domichel/black_star_theremin/Pictures/Complete Black Star Theremin.jpg

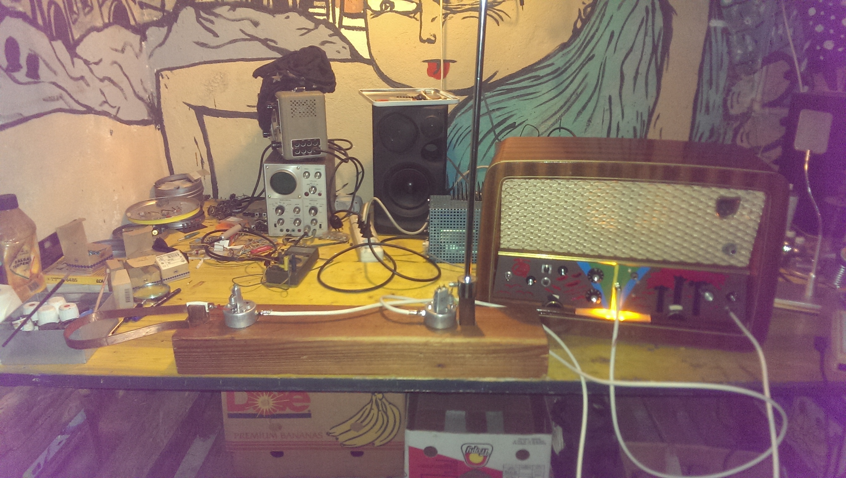
Pictures/Complete Black Star Theremin.jpg
