domichel/black_star_theremin/Pictures/From the front.jpg

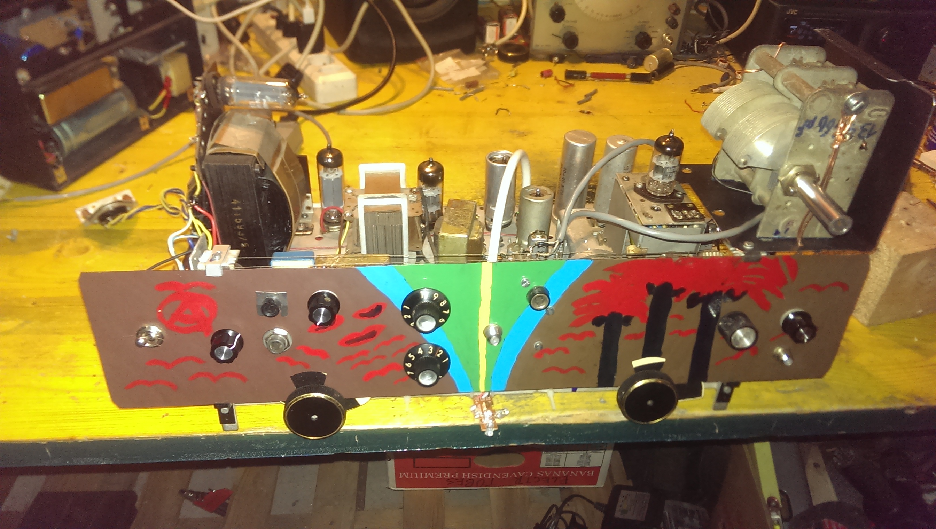
Pictures/From the front.jpg
