domichel/black_star_theremin/Amplifier.jpeg

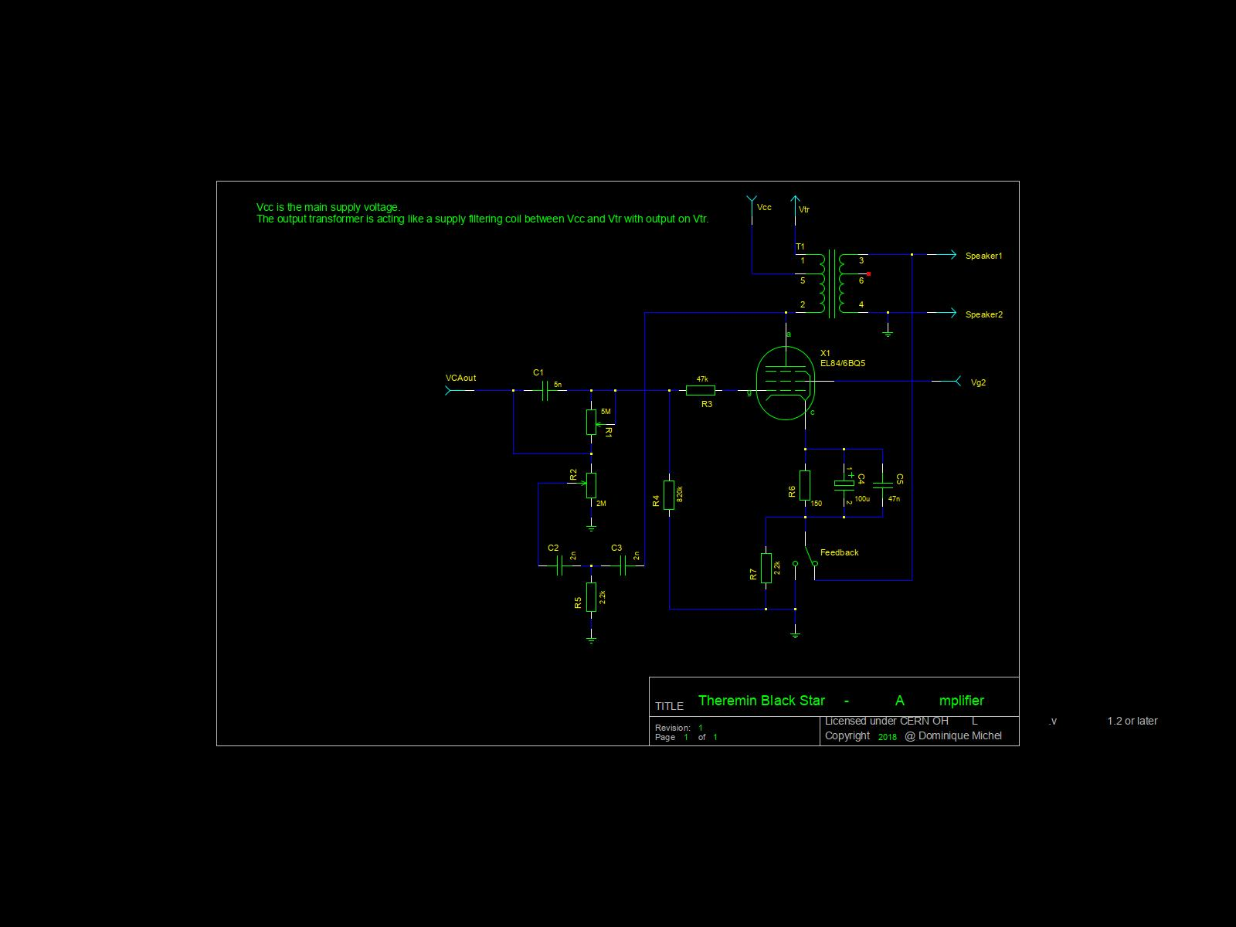
Amplifier.jpeg
