domichel/black_star_theremin/bs451.jpg

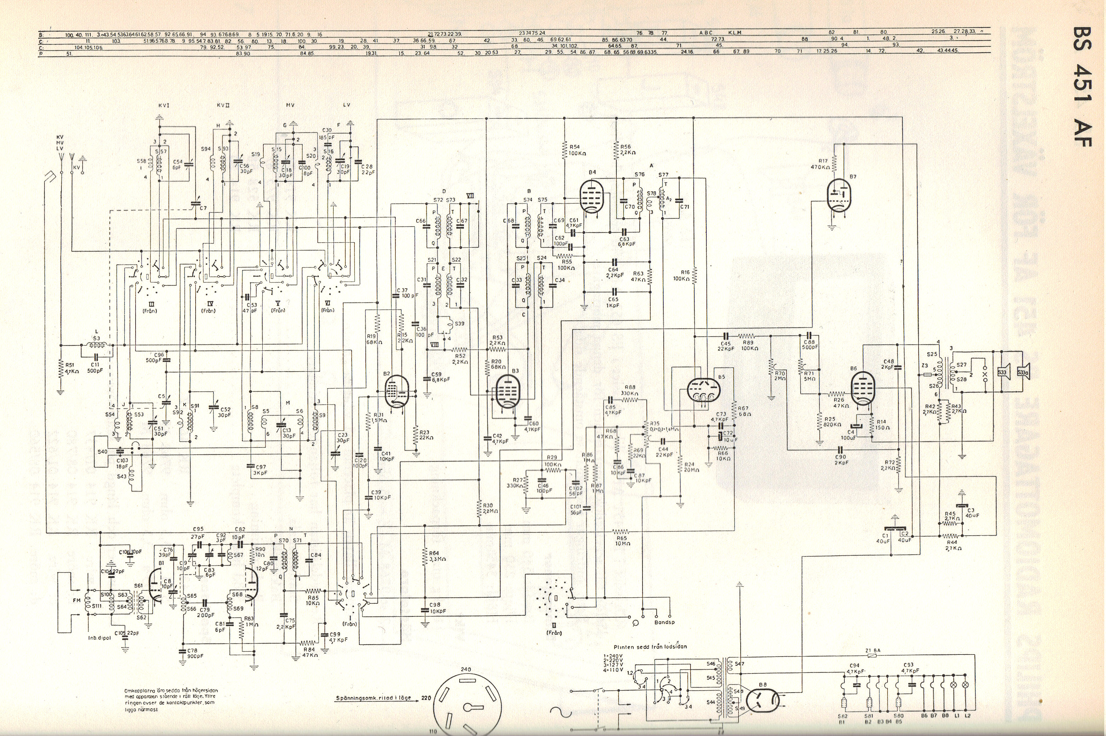
bs451.jpg
