domichel/black_star_theremin/DC_Heater_Supply.jpeg

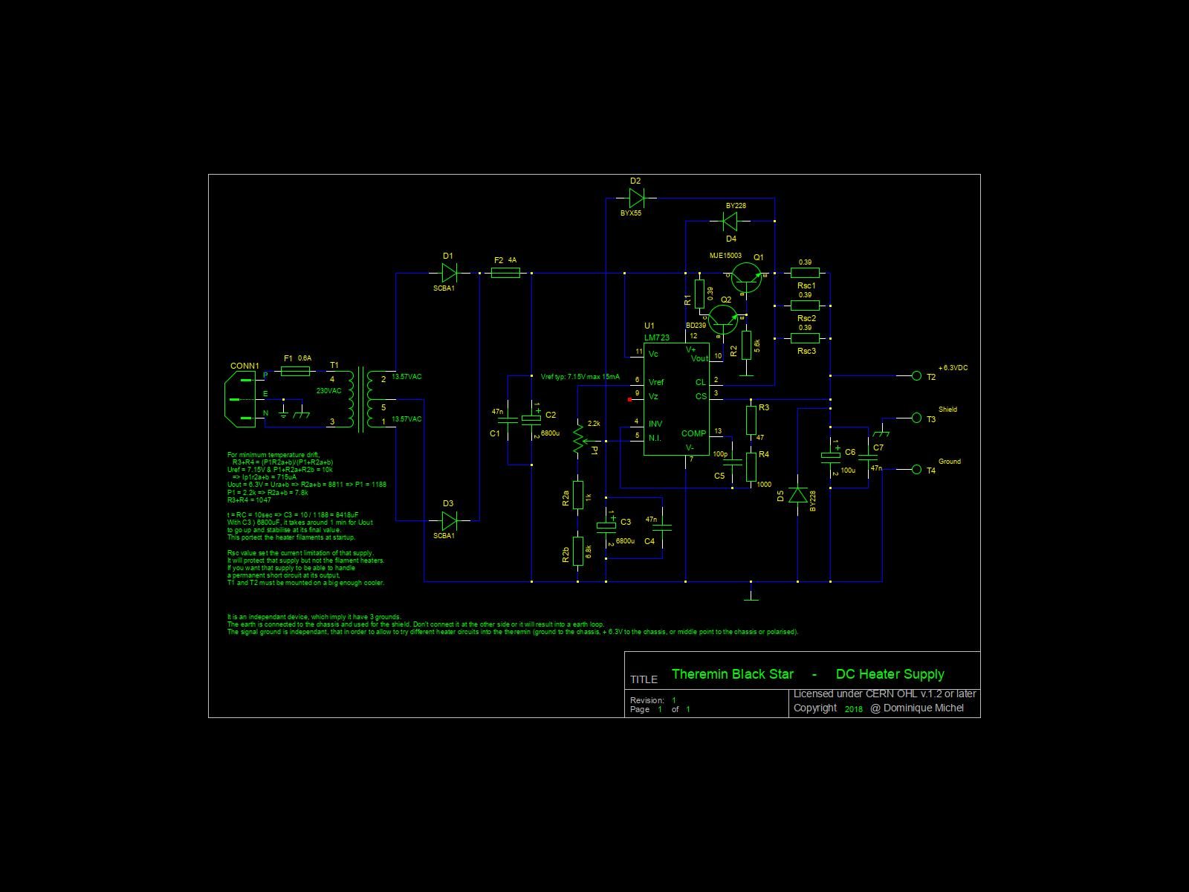
DC_Heater_Supply.jpeg
