domichel/black_star_theremin/Mixer.jpeg

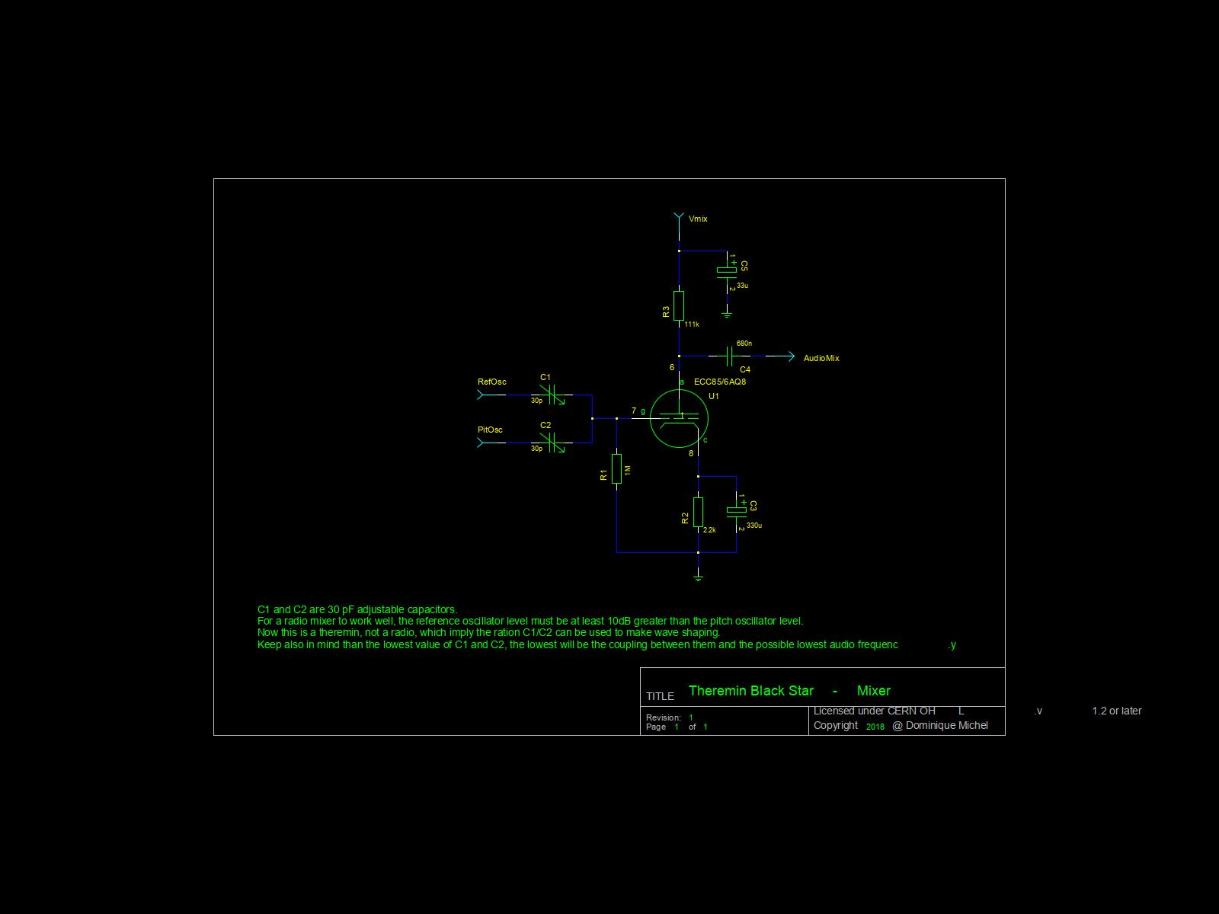
Mixer.jpeg
