domichel/black_star_theremin/Pictures/Black Star Theremin.jpg

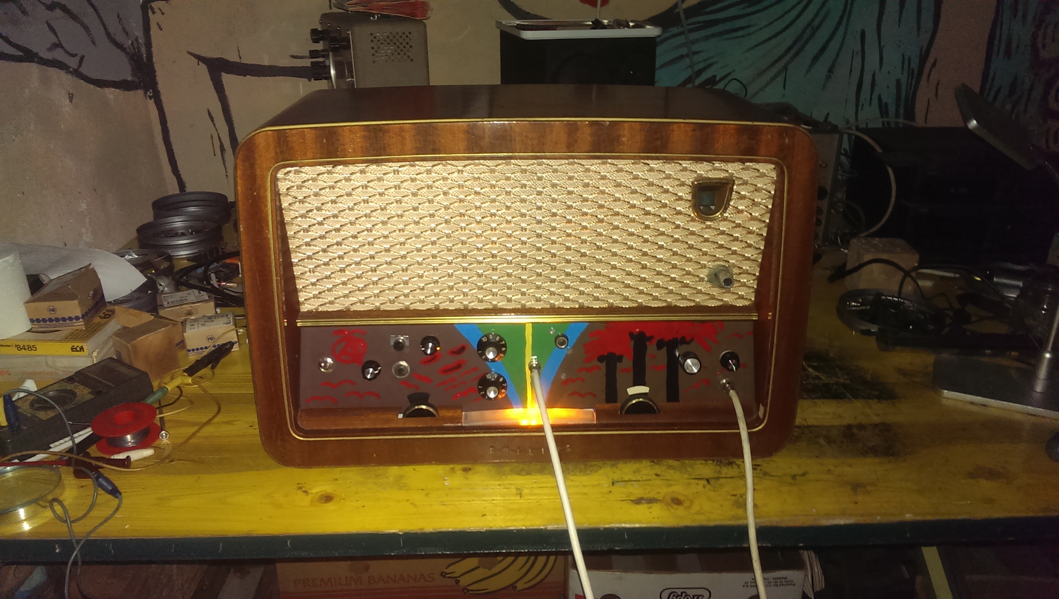
Pictures/Black Star Theremin.jpg
