domichel/black_star_theremin/Pictures/Commands.jpg

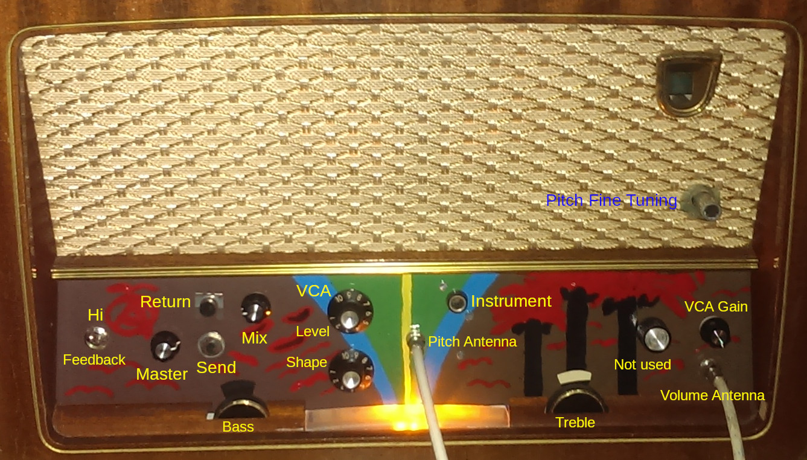
Pictures/Commands.jpg
