domichel/black_star_theremin/Pictures/External DC Heater Supply.jpg

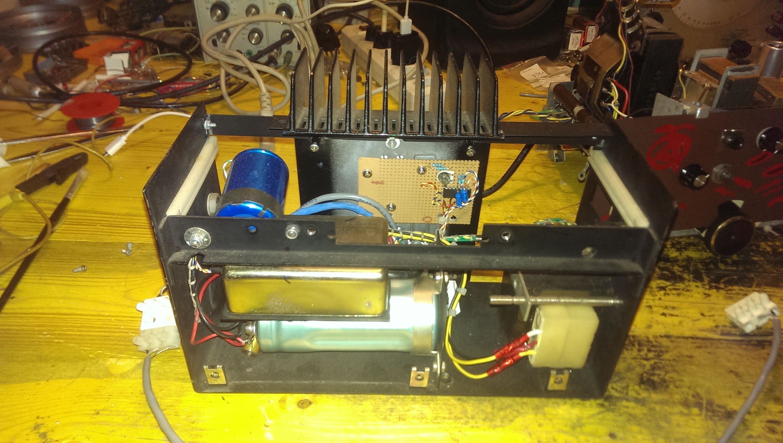
Pictures/External DC Heater Supply.jpg
