domichel/black_star_theremin/Pictures/It begin to work as a theremin.jpg

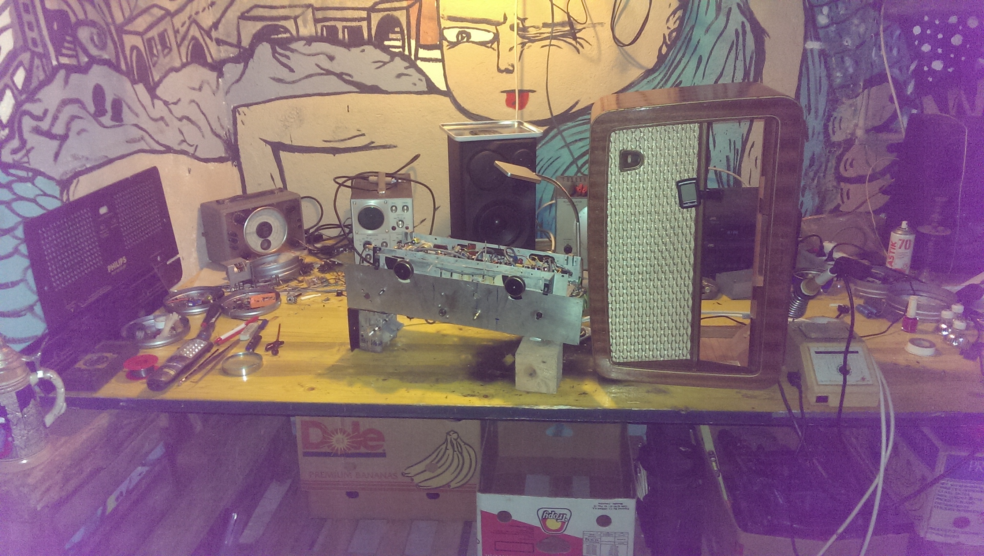
Pictures/It begin to work as a theremin.jpg
