domichel/black_star_theremin/Pictures/It fit inside.jpg

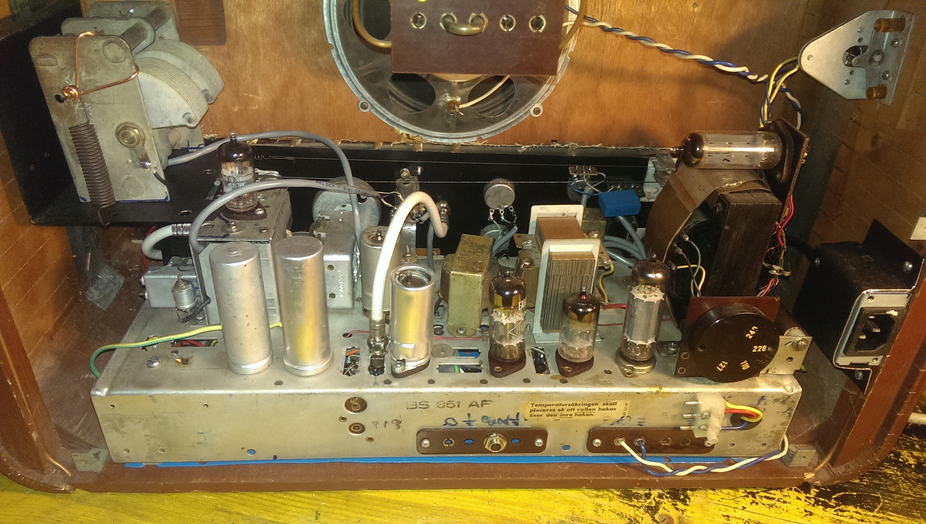
Pictures/It fit inside.jpg
