domichel/black_star_theremin/Pictures/Original radio from the back.jpg

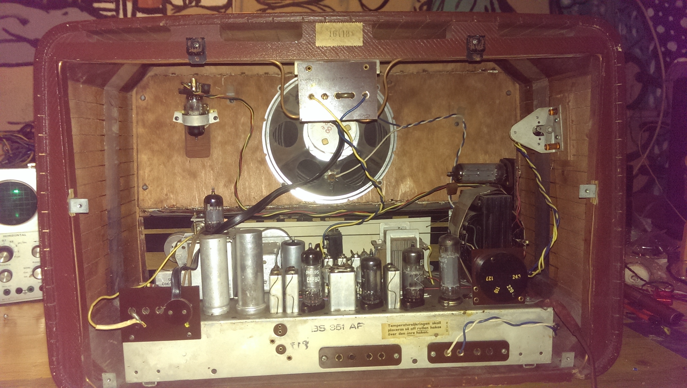
Pictures/Original radio from the back.jpg
