domichel/black_star_theremin/Pictures/Original radio.jpg

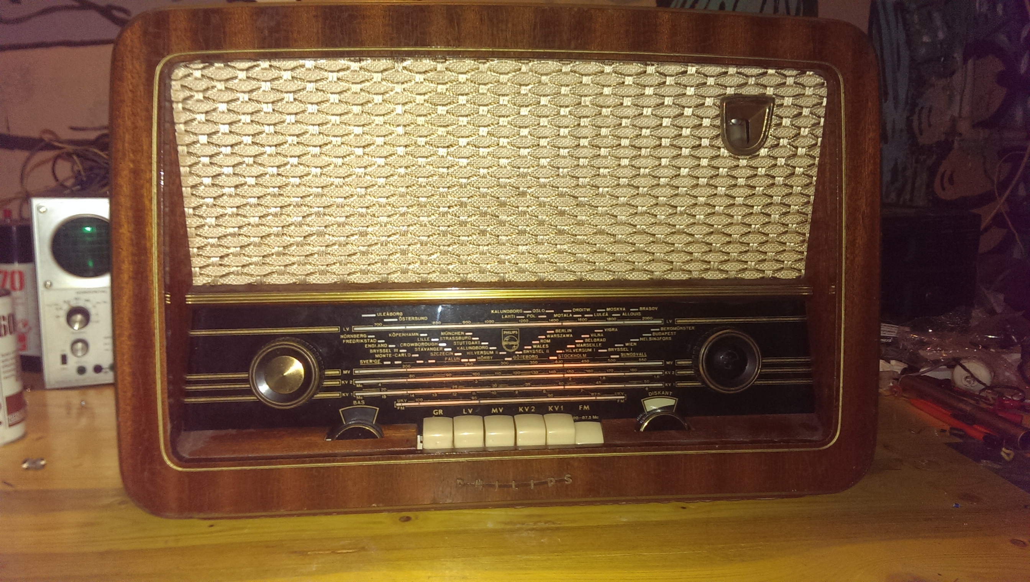
Pictures/Original radio.jpg
