domichel/black_star_theremin/Pictures/The antennas v1.jpg

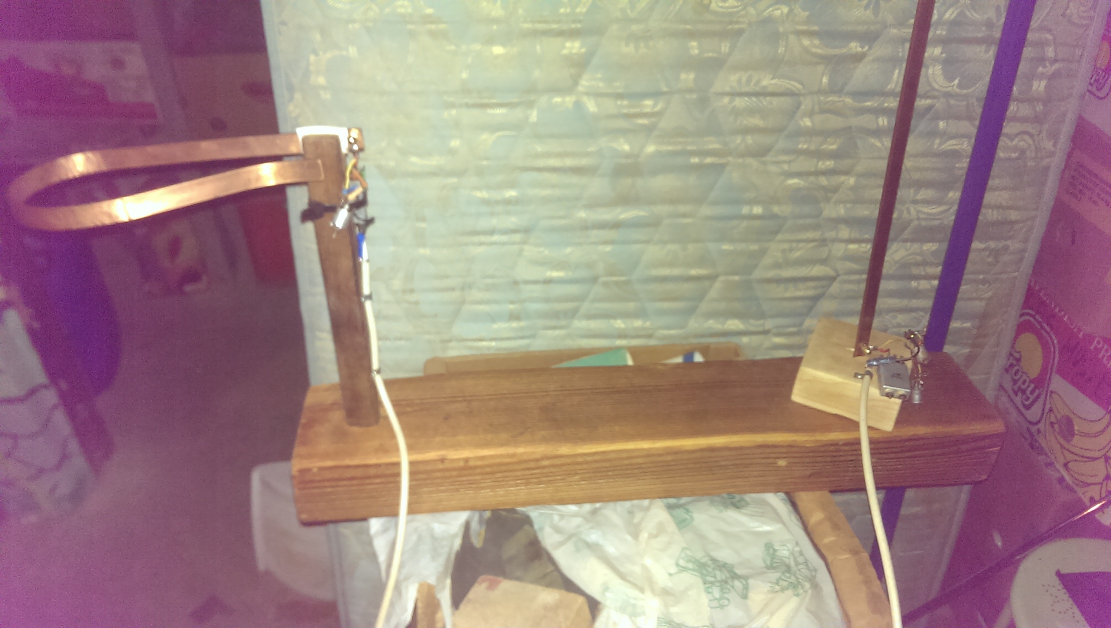
Pictures/The antennas v1.jpg
