domichel/black_star_theremin/Pictures/The antennas v2.jpg

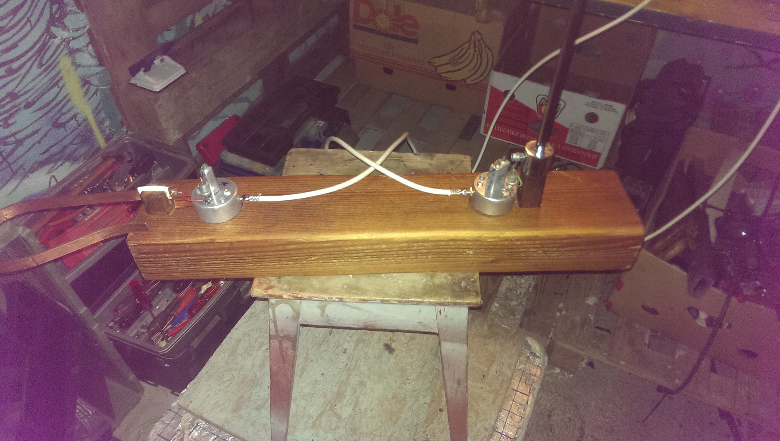
Pictures/The antennas v2.jpg
