domichel/black_star_theremin/Pictures/The inside.jpg

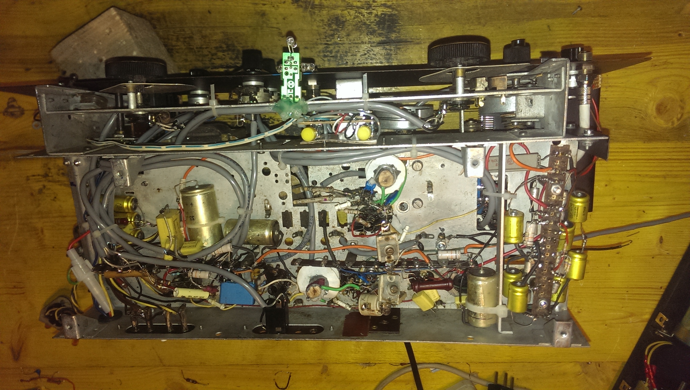
Pictures/The inside.jpg
