domichel/black_star_theremin/PitchOscillator.jpeg

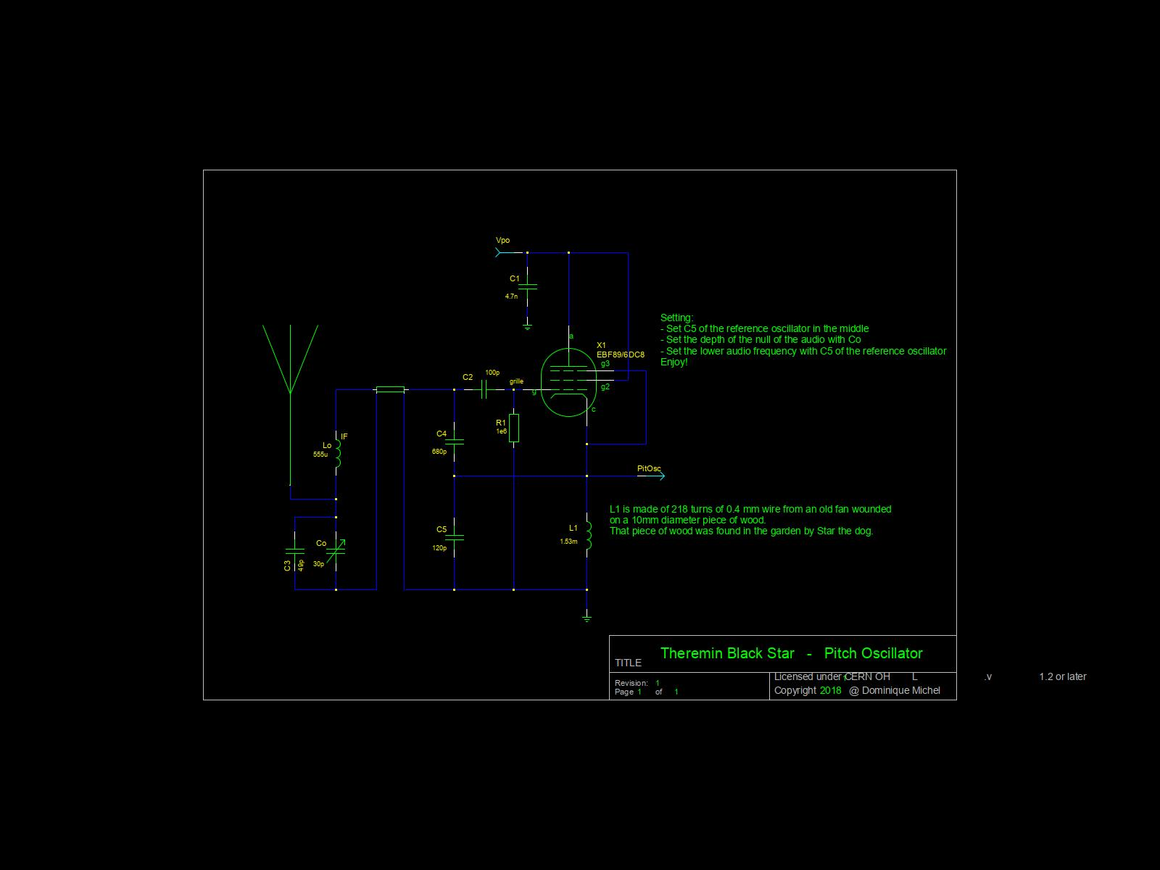
PitchOscillator.jpeg
