domichel/black_star_theremin/Powersupply.jpeg

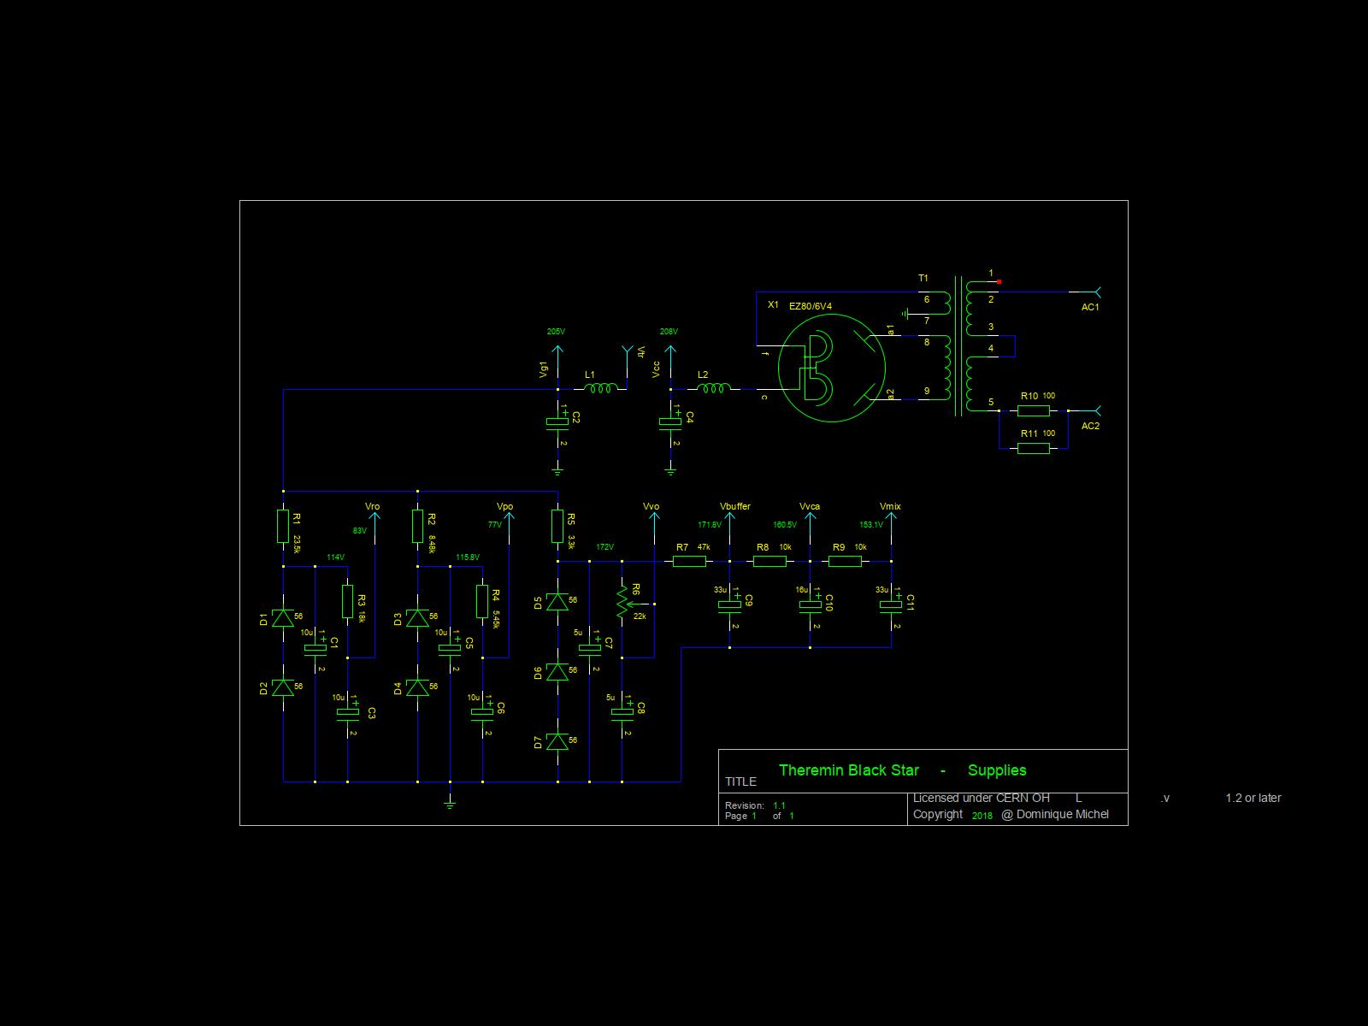
Powersupply.jpeg
