domichel/black_star_theremin/ReferenceOscillator.jpeg

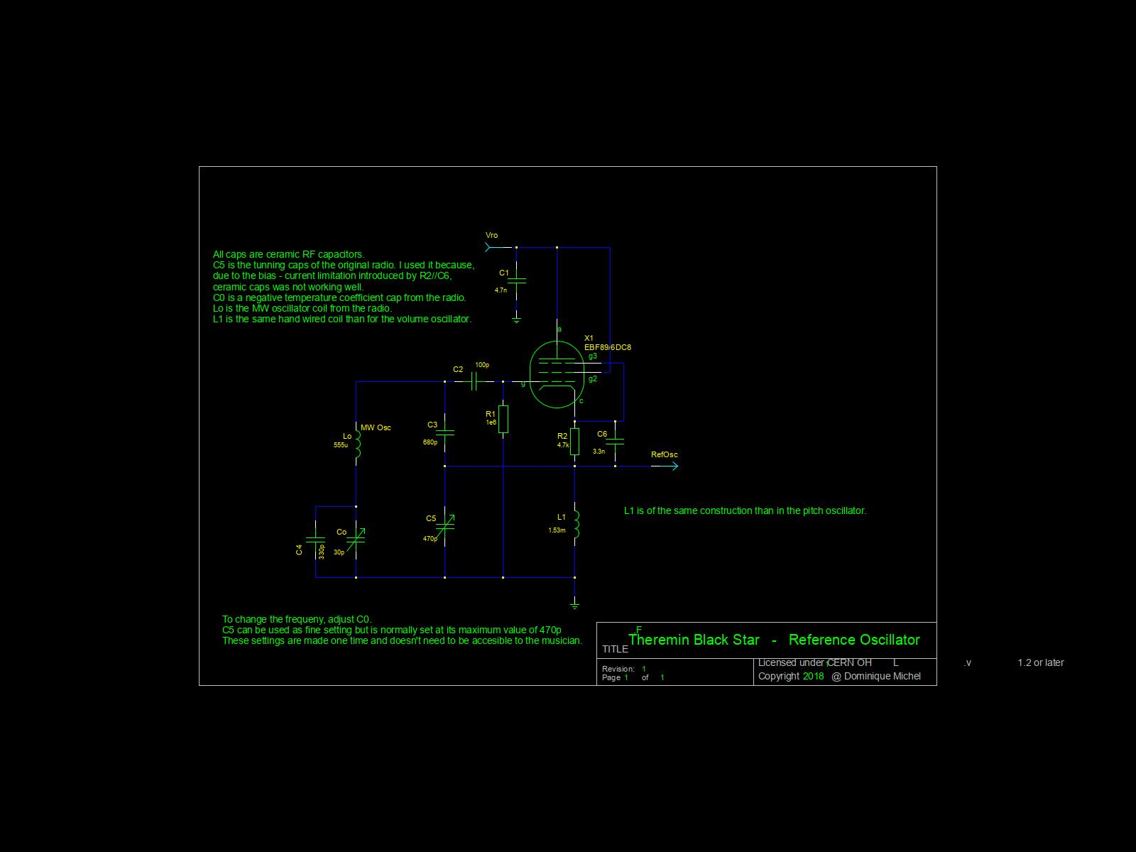
ReferenceOscillator.jpeg
