domichel/black_star_theremin/Theremin.jpeg

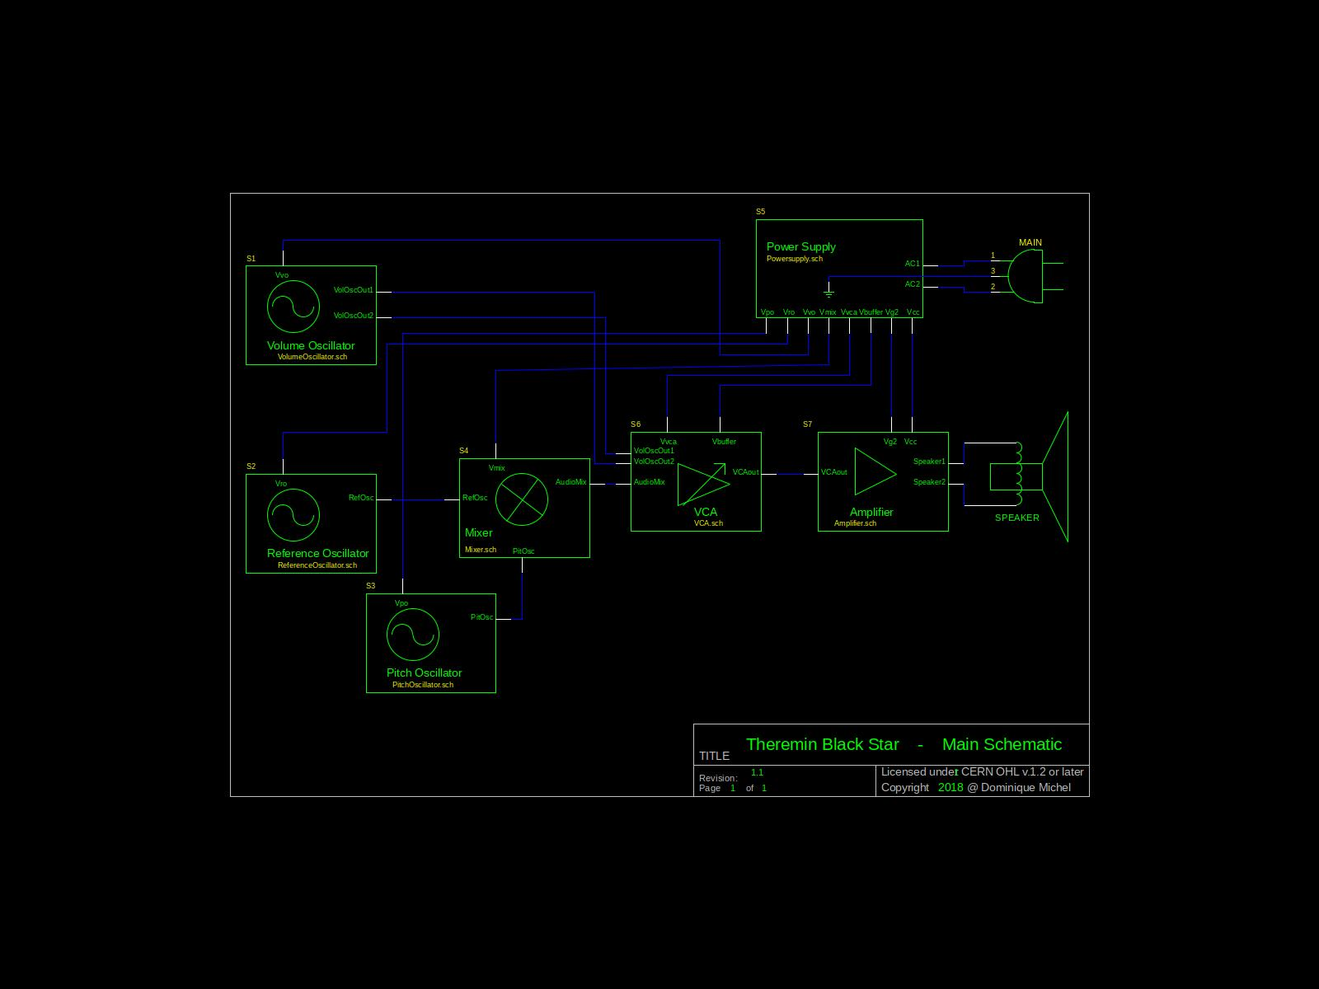
Theremin.jpeg
