domichel/black_star_theremin/VCA.jpeg

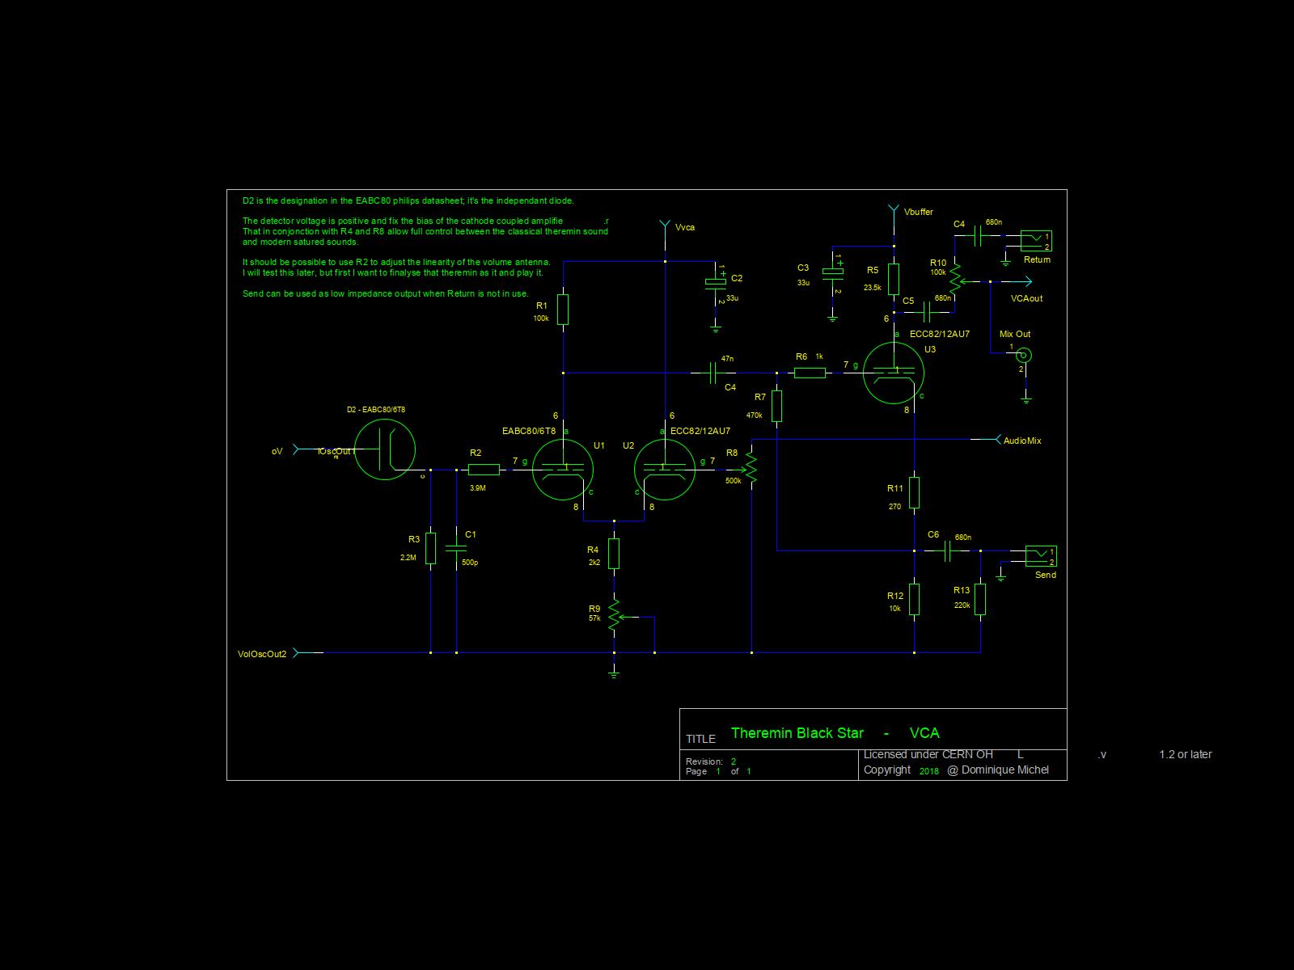
VCA.jpeg
