domichel/black_star_theremin/VolumeOscillator.jpeg

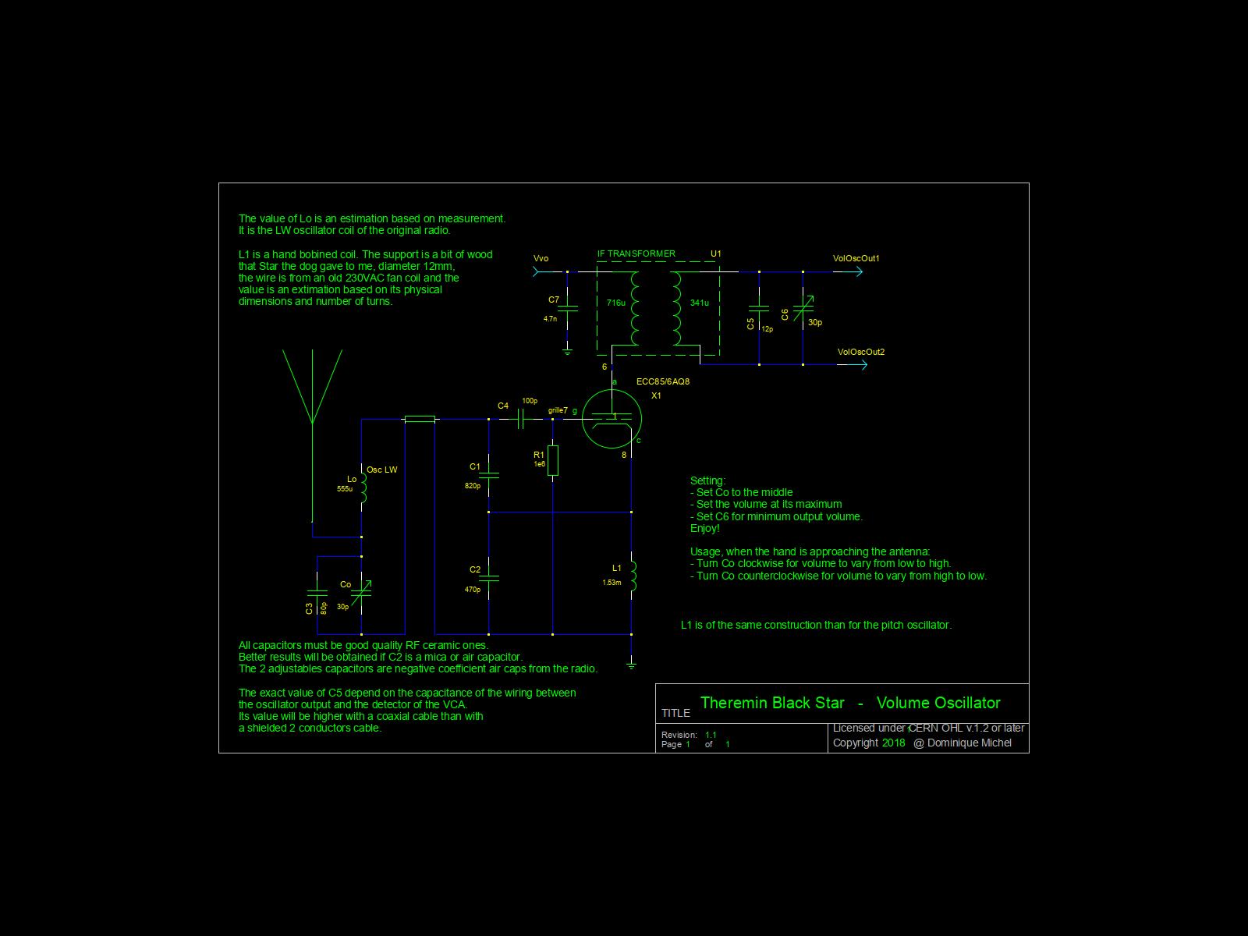
VolumeOscillator.jpeg
