domichel/black_star_theremin/(commit log)

2018-11-25 Import main schematic
    [Theremin.sch]
2018-11-25 Amplifier, Mixer and VCA import
    [Amplifier.sch, Mixer.sch, VCA.sch]
2018-11-25 Mixer v. 1.1
    [VCA.sch]
2018-11-25 Import Volume Oscillator
    [VolumeOscillator.sch]
2018-11-25 Import remaining shematics
    [PitchOscillator.sch, Powersupply.sch, ReferenceOscillator.sch]
2018-11-27 add original radio schematic
2018-12-17 Updated text comment
    [Amplifier.sch]
2018-12-17 Mixer: update text comment
    [Mixer.sch]
2018-12-17 Power supply: add VCA buffer supply
    [Powersupply.sch]
2018-12-17 Reference oscillator: update text comment
    [ReferenceOscillator.sch]
2018-12-17 Main shematic: add VCA buffer supply
    [Theremin.sch]
2018-12-17 Introduce VCA v.2.0 with 2 triodes
    [VCA.sch]
2018-12-17 Volume Oscillator: fix value not in synch with hardware; update comment
    [VolumeOscillator.sch]
2018-12-17 Add signal ground symbol
2018-12-17 Ontroduce DC Heater Supply
    [DC_Heater_Supply.sch]
2018-12-17 Update README.md with the actual stage of this project.
2018-12-23 Fix Co value on the antennas
    [PitchOscillator.sch, VolumeOscillator.sch]
2018-12-25 Add audio samples
2018-12-25 Add pictures from different stages of this project
2018-12-29 Add picture of front panel with commands and connectors names
2019-01-01 Add US tube names.
    [Amplifier.sch, Mixer.sch, PitchOscillator.sch, Powersupply.sch, ReferenceOscillator.sch, VCA.sch, VolumeOscillator.sch]
2019-01-01 Fix valve type
    [ReferenceOscillator.sch]
2019-01-01 Document the custom made coils
    [PitchOscillator.sch, ReferenceOscillator.sch, VolumeOscillator.sch]
2021-05-02 Theremin.*: Cleanup and rearrange
    [Theremin.sch]
